cepdnaclk/e20-co326-group08-Industrial-Fan-Vibration-Based-Predictive-Maintenance/docs/README.md

---
layout: home
permalink: index.html

# Please update this with your repository name and title
repository-name: e20-co326-Industrial-Fan-Vibration-Based-Predictive-Maintenance
title: Industrial Fan Vibration Based Predictive Maintenance
---

[comment]: # "This is the standard layout for the project, but you can clean this and use your own template"

# Industrial-Fan-Vibration-Based-Predictive-Maintenance

---

<!-- 
This is a sample image, to show how to add images to your page. To learn more options, please refer [this](https://projects.ce.pdn.ac.lk/docs/faq/how-to-add-an-image/)

![Sample Image](./images/sample.png)
 -->

## Team
-  E/20/054, M.L. De Croos Rubin, e20054@eng.pdn.ac.lk
-  E/20/197, A.H.D. Kawya, e20197@eng.pdn.ac.lk
-  E/20/211, K.W.I.T. Kumarasinghe, e20211@eng.pdn.ac.lk
-  E/20/093, D.M.B. Edirisooriya, e20093@eng.pdn.ac.lk

## Supervisor
-  Prof. Kamalanath Samarakoon, kamalanath@eng.pdn.ac.lk

## Table of Contents
1. [Introduction](#introduction)
2. [Other Sub Topics](#other-sub-topics)
3. [Links](#links)

---

## Introduction

 description of the real world problem and solution, impact

## Other Sub Topics

.....

## Links

- [Project Repository](https://github.com/cepdnaclk/{{ page.repository-name }}){:target="_blank"}
- [Project Page](https://cepdnaclk.github.io/{{ page.repository-name}}){:target="_blank"}
- [Department of Computer Engineering](http://www.ce.pdn.ac.lk/)
- [University of Peradeniya](https://eng.pdn.ac.lk/)

[//]: # (Please refer this to learn more about Markdown syntax)
[//]: # (https://github.com/adam-p/markdown-here/wiki/Markdown-Cheatsheet)
