cepdnaclk/e20-co326-group08-Industrial-Fan-Vibration-Based-Predictive-Maintenance/(commit log)

2026-04-11 Hardware Implementations
    [fan_dataset.csv]
2026-04-20 Docker compose with mosquitto and python files
    [fan_dataset.csv]
2026-04-28 Version 02 ESP32-S3
    [fan_dataset.csv]
2026-04-29 Enhance README with hardware and wiring details
    Added detailed hardware requirements, wiring instructions, and control system setup for the ESP32-S3 project.
2026-04-30 Added 2 channel Relay File
2026-04-30 Add system flow diagram to README
    Added a system flow diagram using Mermaid syntax to illustrate the data flow and components of the project.
